dariussattari/IMU-Device-for-Powerlifting-Insights/docs/references/IMU_Barbell_Tracker_Assembly_Guide.docx

IMU Barbell Tracker

Complete Assembly Guide

ESP32-S3 Feather + LSM6DSOX IMU + Adalogger FeatherWing

Recommended $86 Build

Darius Sattari & Mashruf Mahin

March 2026

# Before You Begin: Tools & Supplies

Before starting assembly, gather these tools. Nothing here requires soldering — the entire build uses plug-and-play connectors and stacking headers.

- Small Phillips-head screwdriver (for P-clamp bolts)
- Drill with 5mm and 8mm bits (for enclosure holes)
- Hobby knife or deburring tool
- Double-sided foam tape (thin, ~2mm)
- M4 bolt + nut (2x) — from any hardware store, ~$0.50
- USB-C cable (for programming and charging)
- Computer with Arduino IDE or CircuitPython installed

Zero Soldering Required

Every electrical connection in this build uses either STEMMA QT click-connectors or stacking pin headers. If your ESP32-S3 Feather came with loose headers, those do need to be soldered on — but many units ship with headers pre-soldered. Check your package.

# Phase 1: Parts Inventory

Lay out all your parts and check them against this list. Mark each item as you confirm it.

# | Component | Product | Have it?

1 | IMU Sensor | Adafruit LSM6DSOX (#4438)
2 | Microcontroller | ESP32-S3 Feather (#5477)
3 | Data Logger Wing | Adalogger FeatherWing (#2922)
4 | MicroSD Card | SanDisk 16GB Ultra microSDHC
5 | Battery | Adafruit 500mAh LiPo (#1578)
6 | I2C Cable (build) | STEMMA QT 50mm (#4399)
7 | I2C Cable (proto) | STEMMA QT to headers 150mm (#4209)
8 | Mounting Clamps | ISPINNER 2" P-clamps (12-pack)
9 | Enclosure | Zulkit IP65 ABS box 63x58x35mm
10 | Backup Straps | 2" cinch straps (5-pack)
11 | Jumper Wires | ELEGOO 120-piece Dupont set

Battery Polarity Warning

If you substituted an Amazon LiPo battery (e.g., EEMB), verify the JST-PH connector polarity matches Adafruit’s convention BEFORE plugging it in. Adafruit uses positive on the right when the connector tab faces you. Reversed polarity will permanently destroy the ESP32-S3 Feather.

# Phase 2: Electronics Assembly

This phase connects all electronic components. The Feather ecosystem makes this remarkably simple — most connections are just plugging things together.

## Connection Overview

From | Pin/Port | To | Pin/Port
ESP32-S3 Feather | STEMMA QT port | LSM6DSOX | STEMMA QT port
ESP32-S3 Feather | Stacking headers | Adalogger Wing | Stacking headers
Adalogger Wing | MicroSD slot | SanDisk 16GB | (inserted)
ESP32-S3 Feather | JST-PH battery | 500mAh LiPo | JST-PH connector

Step 1: Stack the Adalogger FeatherWing onto the ESP32-S3 Feather

The Adalogger FeatherWing is designed to stack directly on top of the ESP32-S3 Feather using pin headers. Align the pins carefully — the FeatherWing’s female headers should slide onto the Feather’s male header pins. The boards should sit parallel with about 8mm of clearance between them.

- The Adalogger’s MicroSD slot should face outward for easy card access
- Press firmly but evenly — don’t force it at an angle
- The SPI pins (SCK, MOSI, MISO, and a chip-select pin) connect automatically through the stacking headers

Pin Assignment Note

The Adalogger FeatherWing uses SPI for the MicroSD card. On the ESP32-S3 Feather, the default SPI pins are: SCK = GPIO36, MOSI = GPIO35, MISO = GPIO37. The SD chip select defaults to GPIO5. The RTC communicates over I2C (same bus as your IMU) at address 0x68.

Step 2: Connect the LSM6DSOX IMU via STEMMA QT

Take the 50mm STEMMA QT cable (#4399) and click one end into the STEMMA QT port on the ESP32-S3 Feather (it’s the small 4-pin connector on the board edge). Click the other end into the STEMMA QT port on the LSM6DSOX breakout board.

That’s it — the I2C connection (SDA, SCL, 3.3V, GND) is now complete. The cable is keyed so it can only go in one way.

- The LSM6DSOX default I2C address is 0x6A (with the SDO/SA0 pin pulled low)
- If you later add a second IMU, cut the address jumper on one board to change it to 0x6B
- The RTC on the Adalogger also uses I2C (address 0x68) — no conflict, they share the bus

Cable Length Matters

Use the 50mm cable for the final build (keeps the IMU close to the microcontroller inside the enclosure). Use the 150mm STEMMA QT-to-headers cable (#4209) only during prototyping and testing on a breadboard.

Step 3: Insert the MicroSD Card

Insert the SanDisk 16GB microSD card into the Adalogger FeatherWing’s MicroSD slot. The card clicks in with a push-push mechanism (push to insert, push again to eject).

Before first use, format the card as FAT32 using your computer. The ESP32-S3 works best with FAT32-formatted cards under 32GB.

Step 4: Connect the LiPo Battery

Plug the 500mAh LiPo battery’s JST-PH connector into the battery port on the ESP32-S3 Feather (the 2-pin white connector). The connector is keyed and should only fit one way.

- The Feather’s built-in MAX17048 fuel gauge will automatically track battery level
- Charging happens automatically via USB-C when plugged in (500mA charge rate)
- Expected runtime: 2–3 hours continuous (adequate for a 60–90 min training session)

Battery Placement

For the final enclosure build, the battery will sit beneath or beside the stacked Feather boards. The 500mAh cell measures 29 x 36 x 4.75mm and weighs only 10.5g. Use a small piece of foam tape to secure it inside the enclosure so it doesn’t shift during lifts.

At this point, your electronics stack should look like this (bottom to top): ESP32-S3 Feather → Adalogger FeatherWing (stacked on top) → STEMMA QT cable running to the LSM6DSOX board → LiPo battery plugged into the Feather’s JST port.

# Phase 3: Initial Power-Up & Verification

Before putting everything in the enclosure, verify that all components work. This saves you from having to disassemble later.

Step 1: Install Arduino IDE and Board Support

- Install Arduino IDE 2.x from arduino.cc
- In Arduino IDE, go to File → Preferences → Additional Board Manager URLs
- Add: https://raw.githubusercontent.com/espressif/arduino-esp32/gh-pages/package_esp32_index.json
- Go to Tools → Board → Board Manager, search for "esp32", install the Espressif package
- Select board: "Adafruit Feather ESP32-S3" from the ESP32 section

Step 2: Install Required Libraries

In Arduino IDE, go to Sketch → Include Library → Manage Libraries, and install:

- "Adafruit LSM6DS" by Adafruit (includes LSM6DSOX support)
- "Adafruit Unified Sensor" by Adafruit (dependency)
- "SD" (built-in, should already be present)
- "RTClib" by Adafruit (for the Adalogger’s PCF8523 RTC)

Step 3: Upload the Hardware Verification Sketch

Connect the ESP32-S3 Feather to your computer via USB-C. Select the correct COM port in Arduino IDE (Tools → Port). Copy and upload the following test sketch:

// IMU Barbell Tracker — Hardware Verification Sketch

// Tests: IMU (I2C), SD card (SPI), RTC (I2C), Battery gauge

#include <Adafruit_LSM6DSOX.h>

#include <SD.h>

#include <RTClib.h>

#include <Wire.h>

Adafruit_LSM6DSOX lsm;

RTC_PCF8523 rtc;

const int SD_CS = 5; // Adalogger default chip select

void setup() {

Serial.begin(115200);

while (!Serial) delay(10);

delay(1000);

Serial.println("=== IMU Barbell Tracker: Hardware Test ===");

// Test 1: IMU

Wire.begin();

if (lsm.begin_I2C()) {

Serial.println("[PASS] LSM6DSOX found at 0x6A");

lsm.setAccelRange(LSM6DS_ACCEL_RANGE_16_G);

lsm.setGyroRange(LSM6DS_GYRO_RANGE_2000_DPS);

lsm.setAccelDataRate(LSM6DS_RATE_416_HZ);

lsm.setGyroDataRate(LSM6DS_RATE_416_HZ);

Serial.println(" Config: 16g, 2000dps, 416Hz");

} else {

Serial.println("[FAIL] LSM6DSOX not found!");

}

// Test 2: RTC

if (rtc.begin()) {

Serial.println("[PASS] PCF8523 RTC found");

if (!rtc.initialized() || rtc.lostPower()) {

rtc.adjust(DateTime(F(__DATE__), F(__TIME__)));

Serial.println(" RTC set to compile time");

}

} else {

Serial.println("[FAIL] PCF8523 RTC not found!");

}

// Test 3: SD Card

if (SD.begin(SD_CS)) {

Serial.println("[PASS] MicroSD card detected");

File f = SD.open("/test.txt", FILE_WRITE);

if (f) {

f.println("IMU Tracker SD test");

f.close();

Serial.println(" Write test: OK");

}

} else {

Serial.println("[FAIL] MicroSD not detected!");

}

Serial.println("\n=== Starting live IMU stream (5 sec) ===");

}

void loop() {

sensors_event_t accel, gyro, temp;

lsm.getEvent(&accel, &gyro, &temp);

Serial.printf("Accel: %+7.2f %+7.2f %+7.2f ",

accel.acceleration.x,

accel.acceleration.y,

accel.acceleration.z);

Serial.printf("Gyro: %+8.2f %+8.2f %+8.2f\n",

gyro.gyro.x, gyro.gyro.y, gyro.gyro.z);

delay(100); // 10 Hz for readability

}

Step 4: Read the Test Output

Open the Serial Monitor (Tools → Serial Monitor, 115200 baud). You should see:

- [PASS] for all three components (IMU, RTC, SD)
- Live accelerometer and gyroscope readings streaming at 10Hz
- With the board sitting still on a table, accel Z should read ~9.8 m/s² (gravity), and X/Y near 0
- Gyro values should be near zero when stationary (small noise is normal)

If the IMU Test Fails

Double-check the STEMMA QT cable is fully seated on both ends (you should hear/feel a click). If using the 150mm prototyping cable with male headers on a breadboard, ensure SDA goes to SDA and SCL goes to SCL. The I2C address scan might show 0x6B instead of 0x6A if the address jumper was cut — update the code accordingly.

# Phase 4: Enclosure Preparation

The Zulkit IP65 enclosure protects the electronics during heavy lifting. The internal dimensions (63 x 58 x 35mm) are a snug fit for the stacked boards + battery, which is ideal — minimal movement inside means less vibration-induced noise in your IMU data.

Step 1: Plan Your Hole Layout

You need to drill two or three holes in the enclosure:

- USB-C access port (one side wall): ~8 x 3mm rectangular opening, or a 10mm round hole that fits the USB-C plug
- P-clamp mounting bolt hole (bottom): 5mm diameter, centered along the long axis of the bottom face
- Optional second bolt hole: 5mm, ~35mm from the first, for a two-bolt P-clamp mount (recommended for extra rigidity)

Drilling ABS Plastic

ABS drills easily but can crack if you push too hard. Start with a small pilot hole (2mm), then step up to your final size. Go slow, let the bit do the work. For the USB-C slot, drill a 3mm hole and widen it with a hobby knife or small file.

Step 2: Line the Interior with Foam Tape

Cut thin strips of double-sided foam tape and apply them to the bottom interior of the enclosure. This serves two purposes: it cushions the electronics against impact shock, and it immobilizes the boards so they don’t rattle. Leave the top adhesive backing in place for now — you’ll press the electronics stack onto it once everything is tested.

Step 3: Dry-Fit the Electronics

Before committing, place the electronics stack inside the enclosure (without removing the foam tape backing) to verify:

- The USB-C port on the Feather aligns with your drilled hole
- The MicroSD card slot on the Adalogger is still accessible (even if you need tweezers)
- The IMU board and STEMMA QT cable fit without sharp bends
- The battery fits in the remaining space
- The lid closes fully

IMU Orientation Matters

Pay attention to which axis of the LSM6DSOX points along the barbell. Ideally, mount the IMU board so its X-axis (marked on the silkscreen) aligns with the bar’s longitudinal axis. Document which axis points which direction — you’ll need this mapping in firmware for gravity compensation and bar path reconstruction.

# Phase 5: Barbell Mounting (No 3D Printing Required)

Since you don’t have makerspace access yet, this section covers a mounting approach using only the off-the-shelf parts from your BOM. It’s robust enough for heavy powerlifting and can be upgraded later with a 3D-printed bracket.

## Method: P-Clamp + Enclosure + Cinch Strap

Step 1: Attach the P-Clamp to the Enclosure

Take one ISPINNER 2″ rubber-cushioned P-clamp and position it against the bottom of the Zulkit enclosure. The P-clamp’s mounting tab should align with the bolt hole(s) you drilled. Secure with an M4 bolt and nut. Tighten firmly but don’t over-torque (ABS can crack). If using two bolt holes, attach two P-clamps side by side for maximum rigidity.

Step 2: Clamp onto the Barbell Sleeve

Open the P-clamp and position it around the 50mm Olympic barbell sleeve (the rotating outer portion where plates load). The rubber lining grips the smooth chrome surface. Tighten the P-clamp screw until the enclosure is snug and doesn’t rotate or slide when you twist the bar.

- Mount near the inside collar (close to the knurling) to minimize the moment arm from plate loading
- Ensure the device sits between the collar and your weight plates, so plates don’t contact the enclosure
- Mount on the same end every session for consistent data

Step 3: Add the Cinch Strap as Backup Retention

Wrap a 2″ heavy-duty cinch strap around the entire assembly (barbell sleeve + P-clamp + enclosure). This is your safety net. Even if the P-clamp loosens under extreme loads, the cinch strap keeps everything on the bar. The straps are rated for 103 lb shear strength — more than sufficient.

Alternative Mounting Idea

For a one-motion attach/detach solution, buy a cheap pair of lockjaw-style Olympic barbell collars ($8–12 on Amazon) and epoxy or bolt the Zulkit enclosure directly to one collar. You then clamp the tracker on and off the bar the same way you change weight collars — this is what the commercial FORM Lifting Collar product does.

## Final Enclosure Assembly

Once mounting is verified and tested:

1. Remove the foam tape backing inside the enclosure
2. Press the electronics stack firmly onto the foam tape, USB-C port aligned with the access hole
3. Tuck the LiPo battery into the remaining space, secured with its own foam tape strip
4. Route the STEMMA QT cable so it doesn’t pinch when the lid closes
5. Close the lid and verify the four screws seat properly (IP65 seal)

# Phase 6: Post-Assembly Checklist

Run through this checklist to confirm everything is working before your first data collection session.

- Power on: Press the Feather’s reset button. The onboard NeoPixel should light briefly.
- IMU test: Tilt the enclosure in all directions. If connected to Serial Monitor, accel values should change smoothly.
- SD write test: Confirm the test sketch created /test.txt on the SD card. Remove the card, check on your computer.
- RTC test: Unplug USB, wait 10 seconds, replug. The RTC should still report the correct time (not reset to 0).
- Battery test: Unplug USB, verify the board stays powered from the LiPo. Let it run for 5 minutes to confirm stability.
- Mount test: Attach to the barbell, load some weight, and perform a few gentle reps. Check the enclosure hasn’t shifted.
- Vibration test: Rack and unrack the bar firmly. Nothing should rattle or come loose.

## Next Steps

With hardware assembled and verified, you’re ready to move on to firmware development. The key milestones ahead:

6. Write a high-speed data logging sketch (416 Hz, timestamped CSV to SD card)
7. Implement Madgwick filter for orientation estimation
8. Add Zero Velocity Update (ZVU) detection for drift correction
9. Integrate gravity compensation and velocity computation
10. Set up OpenCap for ground-truth validation
11. Begin data collection across squat, bench press, and deadlift

Total assembly time for the hardware: approximately 1–2 hours (most of which is enclosure drilling and dry-fitting). The electronics connection itself takes under 5 minutes thanks to the STEMMA QT ecosystem.

IMU Barbell Tracker — Assembly Guide
