dariussattari/IMU-Device-for-Powerlifting-Insights/(commit log)

2026-04-10 finishing device set-up
2026-04-10 pilot testing with html, kalman filter, and metrics
    [session_20260409_175030.csv]
2026-04-14 Add data collection procedure documentation
    Documented the data collection procedure for the IMU Barbell Tracker, including hardware and software setup, trial running instructions, annotation protocol, and output file details.
2026-04-17 new velocity based strat
2026-04-22 velocity metrics added
2026-04-22 Add FastAPI analysis API under src/api/
    Exposes rep counting, velocity metrics, sticking-point detection, and
    1RM estimation via REST endpoints:
    POST /api/sessions upload CSV (+ annotations)
    GET /api/sessions list
    DELETE /api/sessions/{id} remove
    POST /api/sessions/{id}/analyze velocity + sticking
    POST /api/one-rm multi-session consensus
    Sessions persist to api_storage/sessions/{uuid}/ with a JSON index
    loaded on startup. Plot arrays ship as float32 for compact transport.
    CORS allows localhost:5173 for Vite dev; static mount at / serves the
    built frontend in production.
    Co-Auth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
2026-04-22 Scaffold Vite + React + TS + Tailwind frontend
    Sets up the web UI shell on the `ui` branch: Vite config with
    tailwindcss v4 plugin, a `/api/*` proxy to FastAPI on :8000, and
    shadcn/ui (new-york style, neutral base color) wiring via
    components.json. Tailwind theme variables use oklch with matched
    light/dark modes. Adds .claude/launch.json so the Claude Preview
    MCP can start the dev server.
2026-04-22 Add shadcn/ui primitives and utility helpers
    Drops in the subset needed by the three planned screens: button,
    card, checkbox, dialog, input, label, select, separator, table,
    tabs. Ships the cn() classname merger and a small fmt/fmtDate
    helper used by the data tables.
2026-04-22 Build upload, session-detail, and 1RM-consensus screens
    Three pages wired through React Router backed by a small typed
    API client in src/api/:
    - UploadPage: drag-drop dropzone, per-file metadata form (lifter,
    load, reps, optional annotations), running session list with
    delete, and a multi-select handoff to the 1RM page.
    - SessionDetailPage: method picker (A/B/C/D, default D), a
    Recharts velocity plot with rep-boundary overlays and sticking
    dots, tabs for rep metrics and sticking-point tables.
    - OneRmPage: session picker, load-velocity scatter with linear
    fits, consensus headline with 95% CI, per-estimator and
    per-session summary tables.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
2026-04-22 Redesign frontend as industrial IMU Lab dashboard
    Replace the initial shadcn-style three-page UI with a single-page tabbed
    dashboard matching the research-lab aesthetic: dark theme in OKLCH with
    signal-lime accents, JetBrains Mono + Space Grotesk + Instrument Serif
    typography, and four tabs — Sessions & sets, Analysis, 1RM & sticking,
    Research hypotheses.
    Rewrite index.css with design tokens and section-level classes (masthead,
    panels, session-bar, wave-wrap, reps grid, barpath, lv-chart, stick-viz,
    hyp, contact). Build four tab pages that consume the existing analyze +
    list-sessions APIs, including a Recharts-based Vy(t) readout with
    UNRACK/RE-RACK markers, rep-boundary bands, rep-peak d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
2026-04-22 Unblock 1RM for sessions without n_reps_prescribed and label bar path honestly
    The /api/one-rm endpoint rejected whole requests when any session was
    missing n_reps_prescribed, yet the value is never consumed by the
    estimator math. It only surfaces in the CLI __main__ print. Relax the
    required-fields check to lifter + load_lb, pass 0 through to
    extract_session_features for the int-cast, and let the LVP consensus
    run whenever two or more loads are available.
    Also fix the LVP chart: when the API response is missing, drop the
    fallback that planted every session at MPV=0.5 and produced a bogus
    flat scatter. Prefer real estimator x/y points when present, fall back
    to per-session best_mpv from the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
2026-04-22 Scrub decorative renderings; every pixel is either real data or flagged in-dev
    The frontend had several decorative/handwaved visualizations that looked
    like real outputs but were hardcoded Beziers, tautological confidences,
    or forward-looking claims about pipeline stages that don't exist yet.
    This pass replaces them with real data wherever the backend already
    supplies it, and with explicit "still in development" placeholders
    everywhere else. All plotting scaffolding stays — the SVG viewBoxes,
    coordinate systems, legends, and panel chrome are unchanged — so the
    eventual real signal plugs in as a one-liner.
    AnalysisTab
    - Per-rep sparklines (R1..R5): were a single shared curve. Now each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
2026-04-22 Group sessions by upload batch, not by calendar day
    "+ New session → Upload" was appending to any existing session card
    that happened to share a calendar date. The grouping function bucketed
    by YYYY-MM-DD of uploaded_at, so two distinct workout sessions entered
    on the same day collapsed into one row with no way for the UI to tell
    them apart.
    Switch to time-gap batching: adjacent uploads (sorted by uploaded_at)
    stay in the same batch while the gap is ≤120s, and any larger gap
    starts a new batch. Sequential uploads within one "+ New session"
    click land seconds apart, so they group correctly; a real
    between-sessions pause always exceeds two minutes, so the new batch
    gets its own card.
    Eac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
2026-04-22 Add delete button to each session card
    Each session card in the left list now shows a small × to the right
    of the set-count when the card is hovered, selected, or its button is
    focused. Clicking it prompts to confirm, then deletes every set in
    that batch via the existing /api/sessions/{id} DELETE endpoint and
    refreshes. stopPropagation keeps the button from also toggling
    session selection.
    Styling mirrors the existing per-set × in the detail table — 1 px
    ink-400 border, mono ×, var(--hot) on hover — so the two delete
    affordances feel like one vocabulary rather than two bolted-on
    widgets. The row grid grew from three columns to four (64px | body |
    count | del) so nothing shifts when t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
2026-04-23 Rename IMU Lab to Barbell Lab and add barbell mark
    The wordmark is now "Barbell Lab" across the masthead, topbar, footer,
    browser tab title, and research contact card. "IMU" stays where it
    still refers to the physical sensor — rep-counting hypothesis copy,
    upload prompts, session-card filename column — since there the
    acronym is technical content, not branding.
    Two new inline SVG components carry the mark. BarbellMark is the full
    180x48 logo that sits next to the masthead wordmark: steel plates on
    the left in --bone, a bar with seven knurled grip marks across the
    shaft, and a --sig lime plate on the right with a 16%-opacity fill
    glow and five telemetry ticks. The visual pun is intention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
2026-04-24 Add src/bar_path/: per-rep 3-D bar path reconstruction + FastAPI router
    Single-IMU bar path is drift-bounded by integrating each rep's
    eccentric and concentric phases separately, with v=0 endpoint anchors
    on both ends of each sub-window. Orientation is fitted once from the
    pre-lift calibration (gyro integration over a session flipped world-Z
    on real data and was removed). Built to merge cleanly with main's
    /api/sessions/{id}/* routes and frontend's analysis tab — see README
    for the two-line app.py diff and frontend types patch.
    https://claude.ai/code/session_01RHNwBaDEhqc6SHR6obY6cp
2026-04-24 Wire bar_path_router into the API app
    Mounts POST /api/sessions/{session_id}/bar-path. The router reuses the
    existing SessionStore so uploaded sessions flow through to bar-path
    reconstruction with no duplicate upload path.
    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
2026-04-24 Wire real bar-path data into the AnalysisTab sagittal plot
    - Add BarPathRep / BarPathResponse types + getBarPath client helper
    - Fetch bar-path once per selected session (independent of velocity method)
    - Replace the schematic SVG loop with per-rep x_m/z_m traces from the
    backend's /api/sessions/:id/bar-path endpoint; best rep highlighted
    with lockout+chest markers, others drawn faintly
    - Update axis labels to match new cm-per-pixel mapping
    - Swap the Propulsive-frac stat for Forward-drift (peak_x_dev_m) in
    the barpath-foot; ROM now sourced from bar-path when available
    - Flip the "schematic" chip to "reconstructed" / "unavailable" based
    on whether the backend returned data
    https://c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
2026-05-02 Rewrite README to match repo + ship reference dataset
    The README was tracking an earlier, more aspirational design (NN-based
    rep counting, EKF bar-path, ML training pipeline, src/preprocessing
    entry points). Bring it in line with what's actually shipped:
    - Hypotheses now describe the implemented pipelines: Schmitt-trigger
    rep counter, calibration-only orientation for bar path, LVP +
    fallback estimator stack for 1RM, valley-detection sticking points.
    - Repo-structure tree drops empty/aspirational dirs and adds
    src/api, src/sticking_point, src/bar_path, frontend, data_collection,
    validation that were previously unmentioned.
    - Setup instructions split cleanly: Python env,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
    [D_135_10_bad_session_20260416_133338.csv, D_135_10_bad_session_20260416_133338_annotations.csv, D_135_10_session_20260416_134111.csv, D_135_10_session_20260416_134111_annotations.csv, D_155_8_session_20260416_133532.csv, D_155_8_session_20260416_133532_annotations.csv, D_175_5_session_20260416_133713.csv, D_175_5_session_20260416_133713_annotations.csv]
